EthanBula/Cama_Hospital/Captura 1.PNG

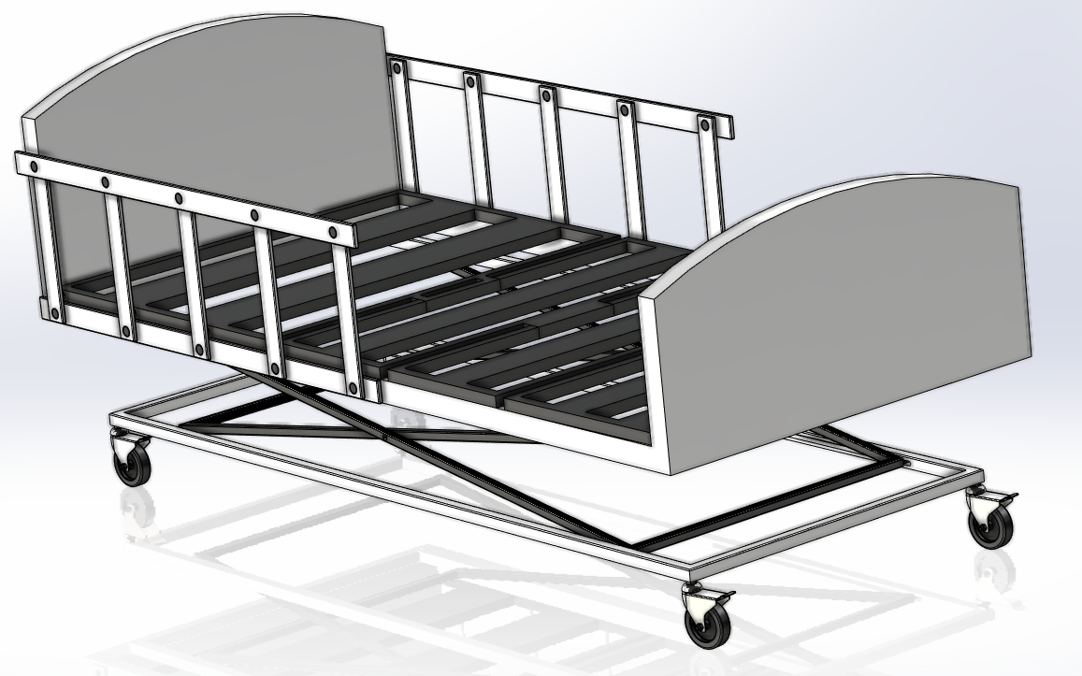
Captura 1.PNG
