EthanBula/Cama_Hospital/Captura 2.PNG

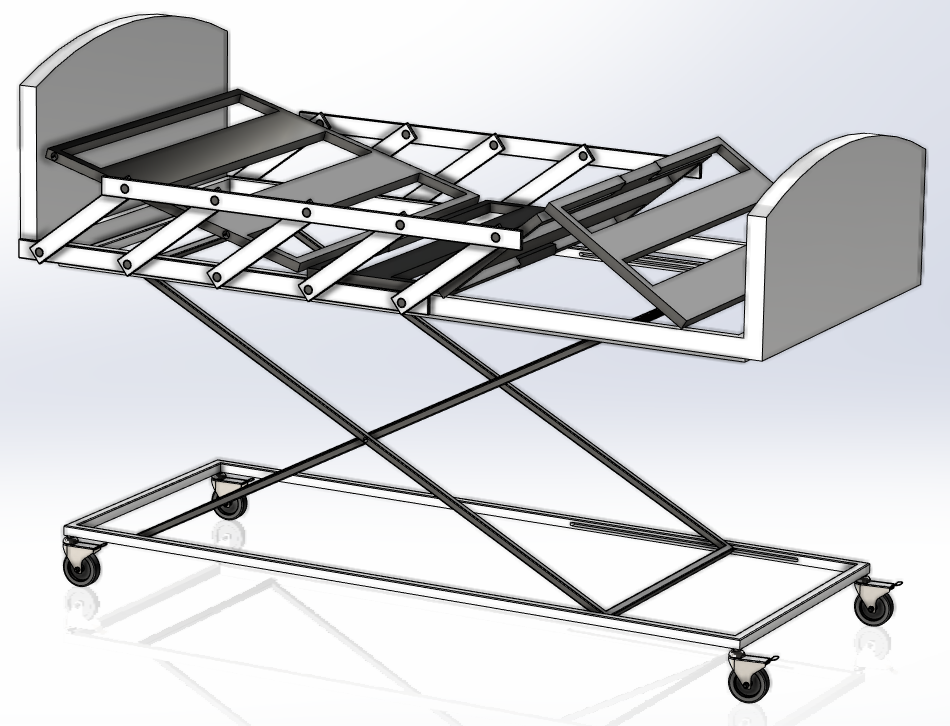
Captura 2.PNG
