EthanBula/Cama_Hospital/cama hospital.SLDASM

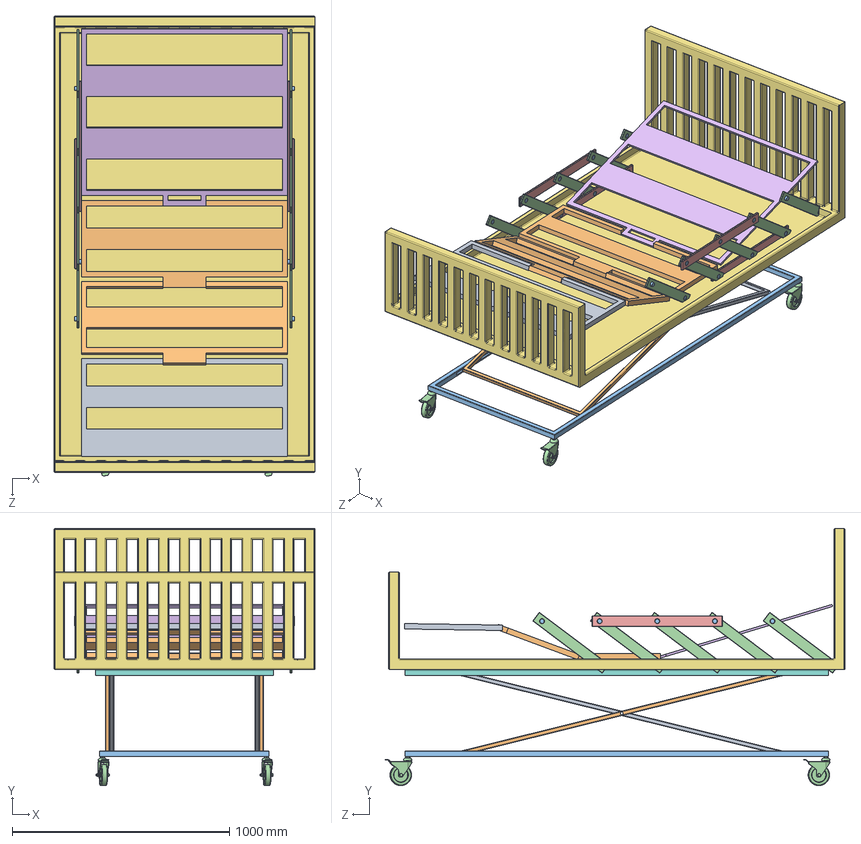
[picture p25: CAD file, 2025-08-15]
cama hospital.SLDASM
1200.0 x 1183.0 x 2116.5 mm
Rueda x 4
base ruedas
ajustador de altura movil
ajustador de altura fijo
base de altura superior
base colchón
espaldar
eslabón baranda horizontal x 4
eslabón baranda vertical x 10
unión baranda x 20
reposa pierna x 2
reposa pies
