EthanBula/Cama_Hospital/baranda.SLDASM

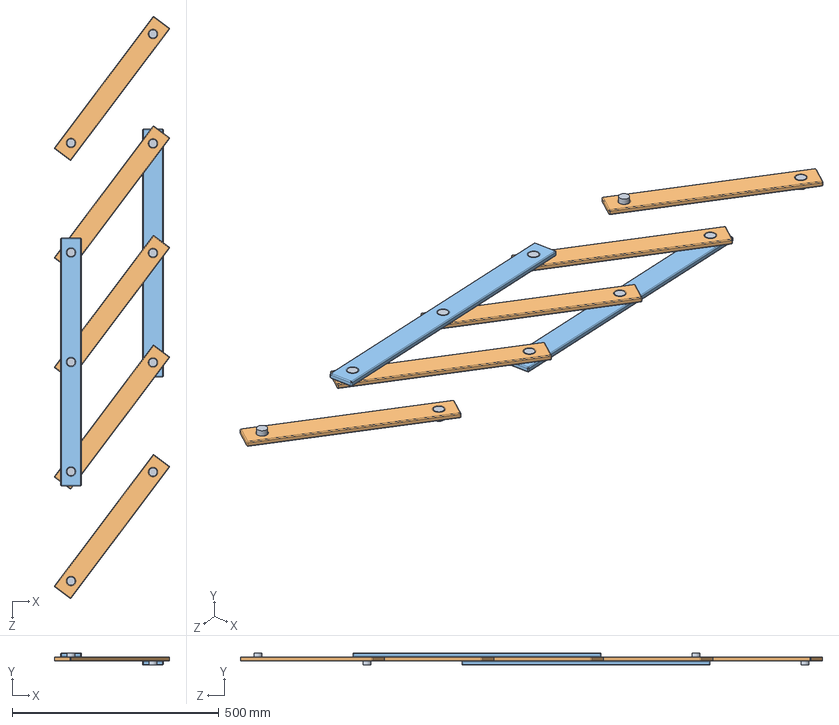
[picture p26: CAD file, 2025-08-15]
baranda.SLDASM
278.7 x 30.0 x 1408.2 mm
eslabón baranda horizontal x 2
eslabón baranda vertical x 5
unión baranda x 10
