EthanBula/Cama_Hospital/unión baranda.SLDPRT

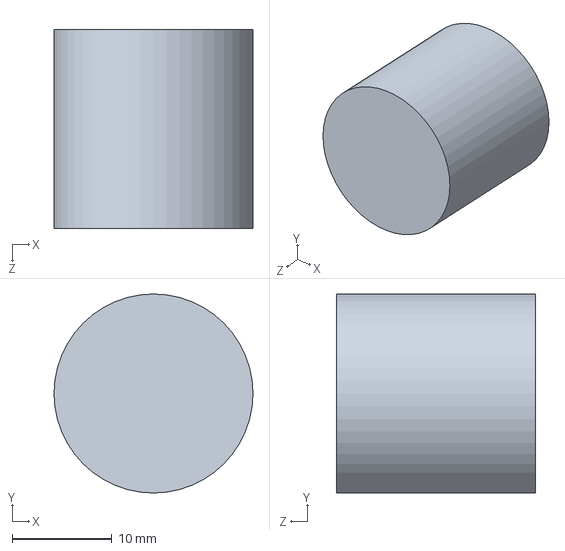
[picture p27: CAD file, 2025-08-15]
unión baranda.SLDPRT
20.0 x 20.0 x 20.0 mm
