EthanBula/Cama_Hospital/eslabón baranda vertical.SLDPRT

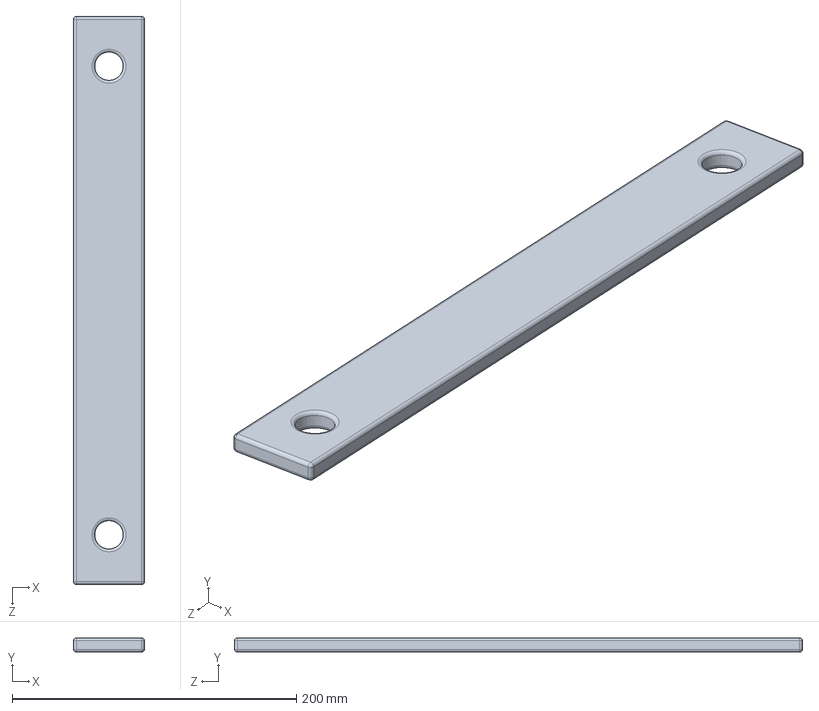
[picture p28: CAD file, 2025-08-15]
eslabón baranda vertical.SLDPRT
50.0 x 10.0 x 400.0 mm
