EthanBula/Cama_Hospital/ajustador de altura fijo.SLDPRT

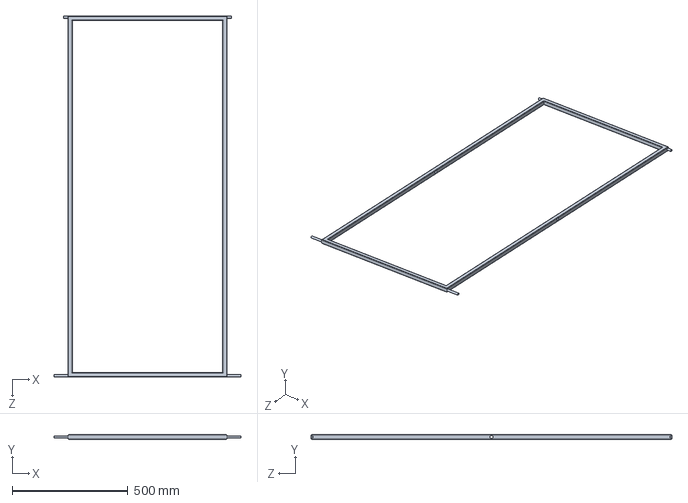
[picture p29: CAD file, 2025-08-15]
ajustador de altura fijo.SLDPRT
806.0 x 19.5 x 1560.0 mm
