EthanBula/Cama_Hospital/ajustador de altura movil.SLDPRT

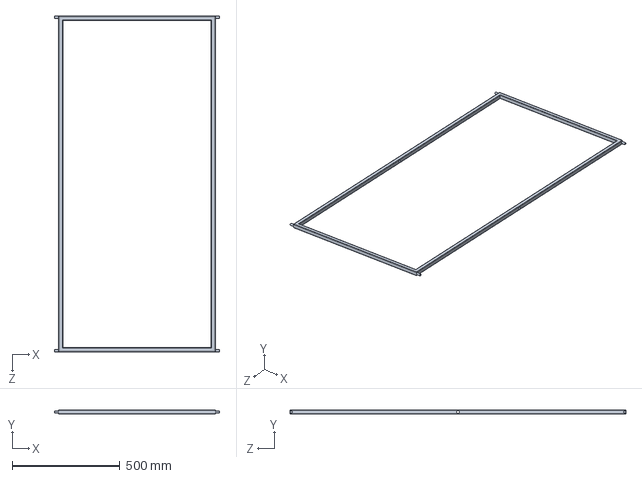
[picture p30: CAD file, 2025-08-15]
ajustador de altura movil.SLDPRT
767.0 x 19.5 x 1560.0 mm
