EthanBula/Cama_Hospital/reposa pies.SLDPRT

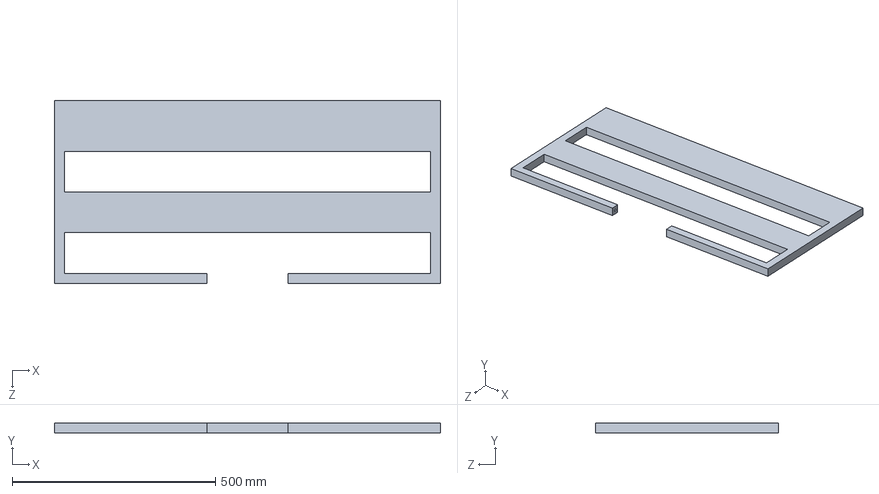
[picture p31: CAD file, 2025-08-15]
reposa pies.SLDPRT
950.0 x 25.0 x 450.0 mm
