EthanBula/Cama_Hospital/espaldar.SLDPRT

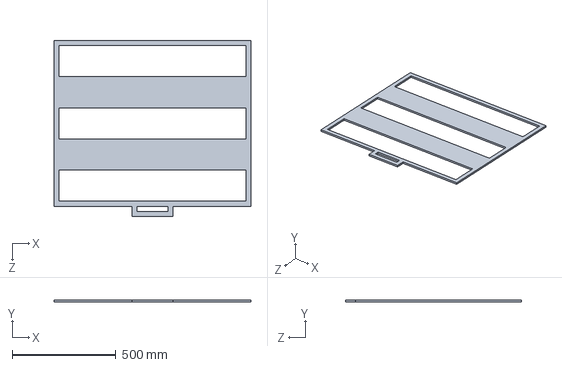
[picture p32: CAD file, 2025-08-15]
espaldar.SLDPRT
950.0 x 10.0 x 850.0 mm
