EthanBula/Cama_Hospital/Rueda.SLDPRT

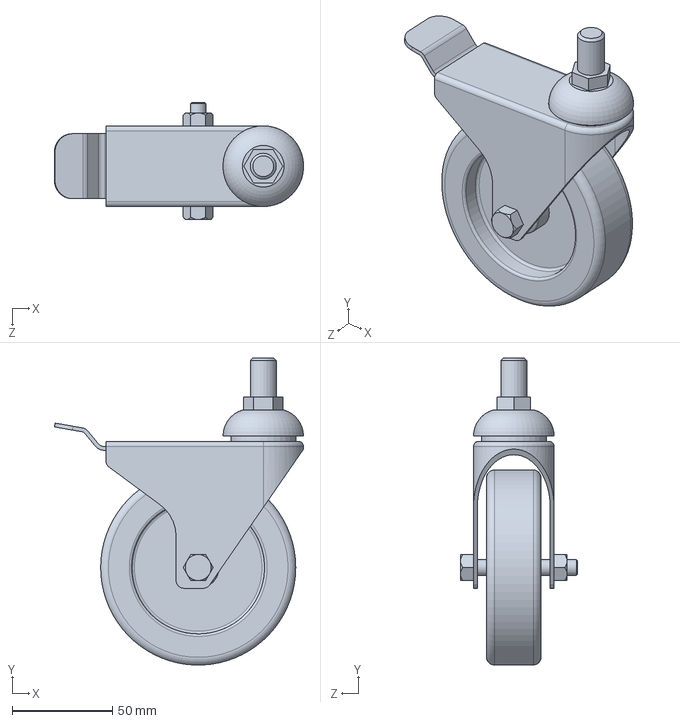
[picture p33: CAD file, 2025-08-15]
Rueda.SLDPRT
124.5 x 153.4 x 58.5 mm
