EthanBula/Cama_Hospital/eslabón baranda horizontal.SLDPRT

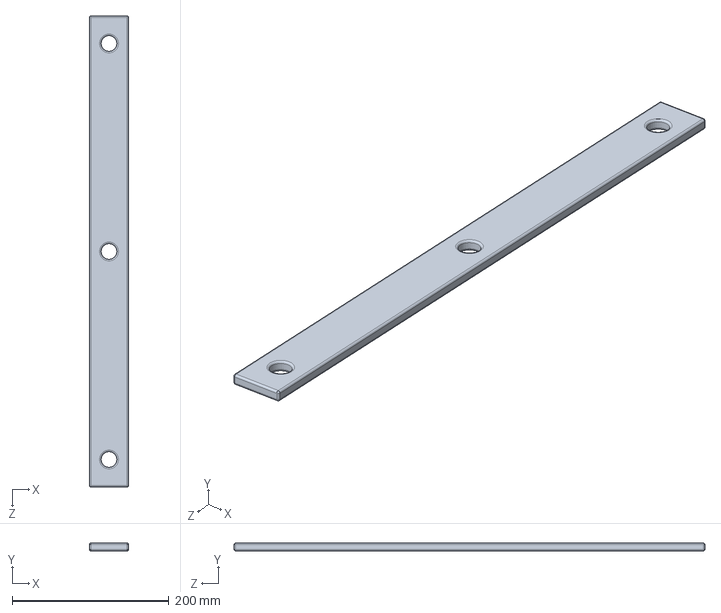
[picture p34: CAD file, 2025-08-15]
eslabón baranda horizontal.SLDPRT
50.0 x 10.0 x 600.0 mm
