EthanBula/Cama_Hospital/reposa pierna.SLDPRT

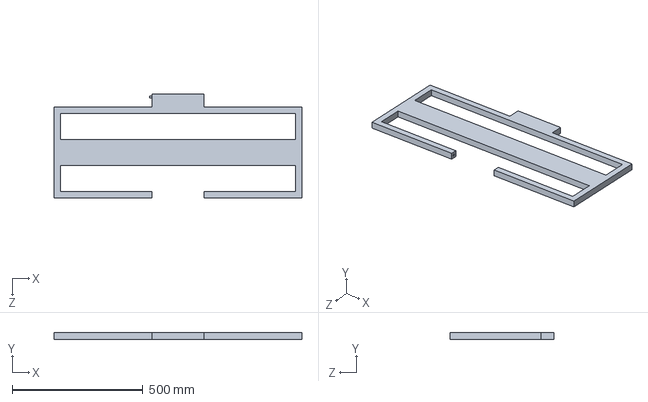
[picture p35: CAD file, 2025-08-15]
reposa pierna.SLDPRT
950.0 x 25.0 x 400.0 mm
