EthanBula/Cama_Hospital/base colchón.SLDPRT

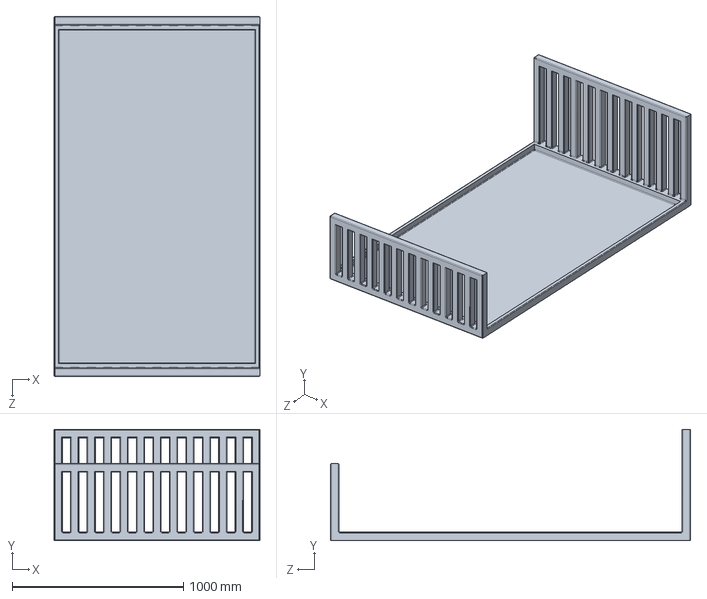
[picture p36: CAD file, 2025-08-15]
base colchón.SLDPRT
1200.0 x 650.0 x 2100.0 mm
