EthanBula/Cama_Hospital/base de altura superior.SLDPRT

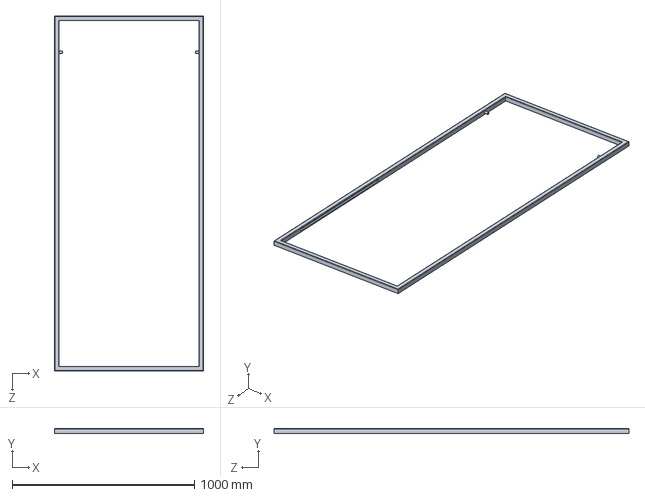
[picture p37: CAD file, 2025-08-15]
base de altura superior.SLDPRT
819.0 x 26.0 x 1950.0 mm
