EthanBula/Cama_Hospital/base ruedas.SLDPRT

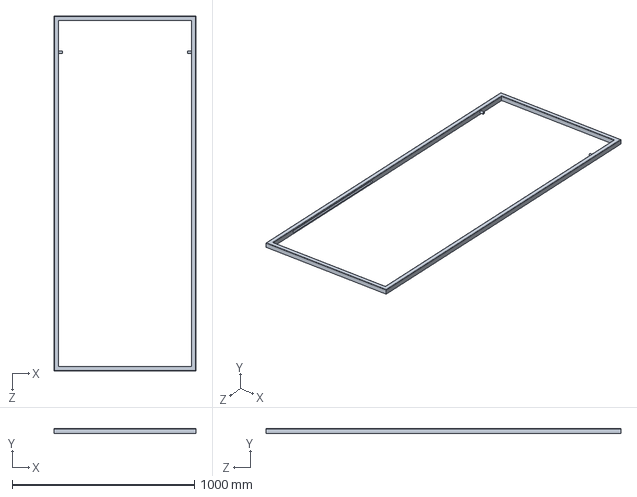
[picture p38: CAD file, 2025-08-15]
base ruedas.SLDPRT
780.0 x 26.0 x 1950.0 mm
